ZIOCC/Zio-Qwiic-Micropython-Pyboard--STM32/images/2.jpg

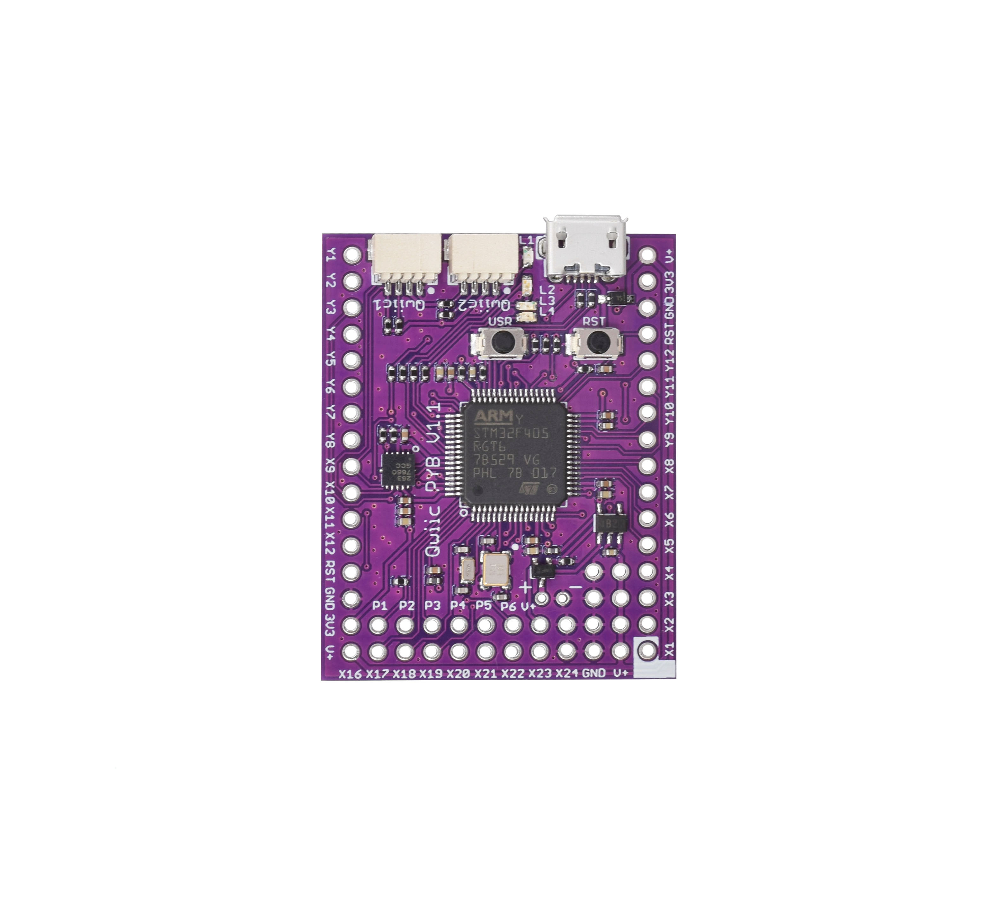
images/2.jpg
