ZIOCC/Zio-Qwiic-Micropython-Pyboard--STM32/images/4.jpg

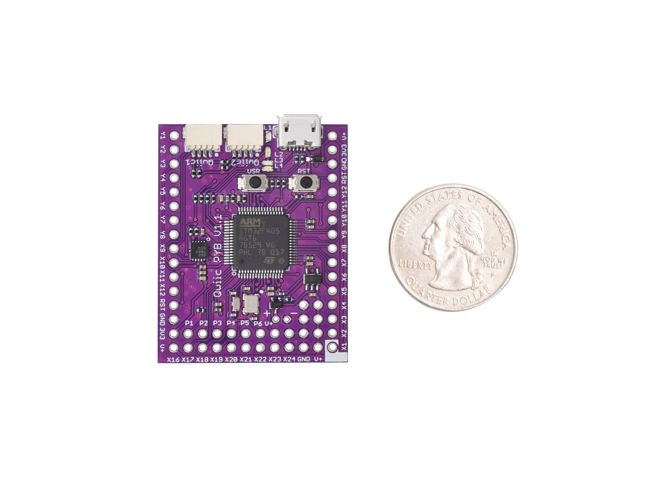
images/4.jpg
