ZIOCC/Zio-Qwiic-Micropython-Pyboard--STM32/images/1.jpg

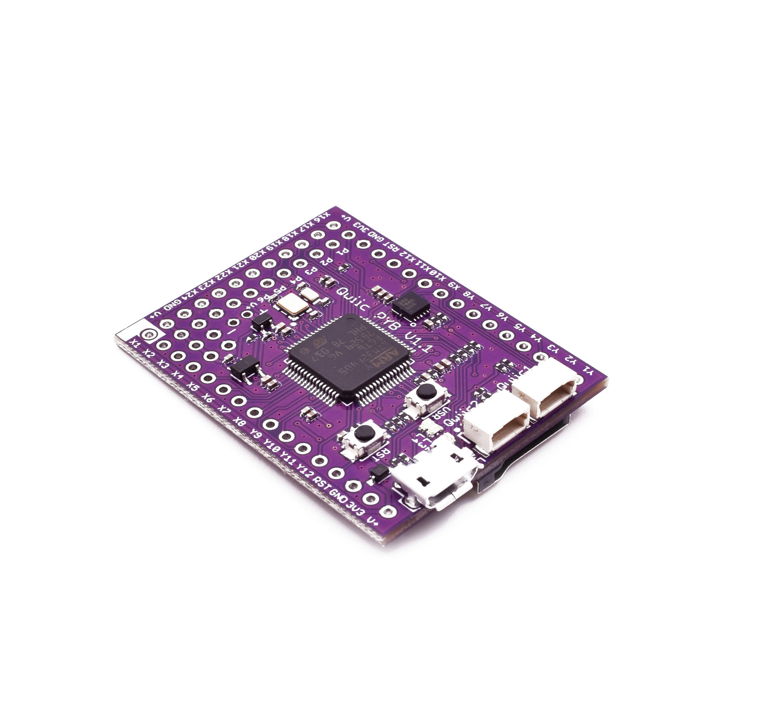
images/1.jpg
