ZIOCC/Zio-Qwiic-Micropython-Pyboard--STM32/images/3.jpg

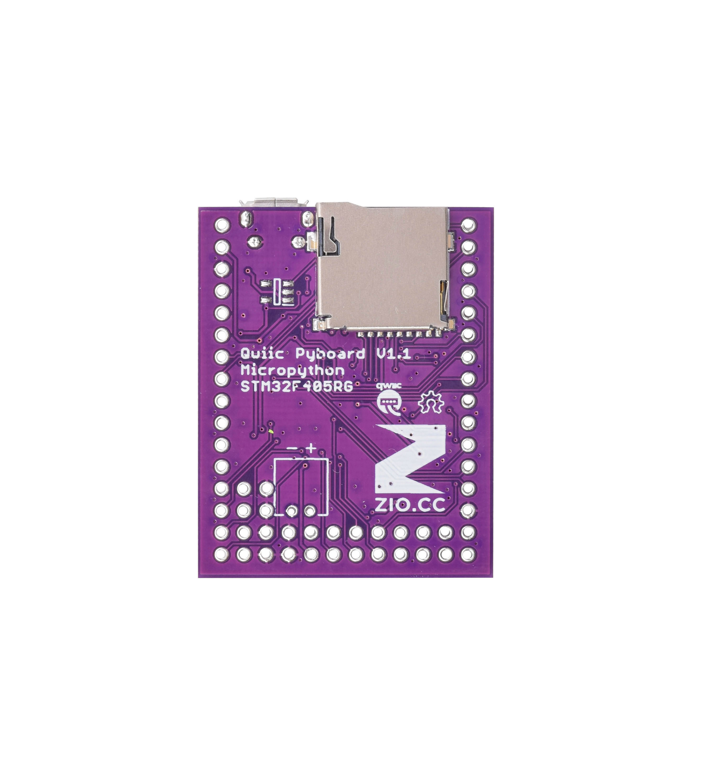
images/3.jpg
