ZIOCC/Zio-Qwiic-Micropython-Pyboard--STM32/BOM.xlsx

 | BOM/PCBA quantity:
 | Project Name:
# | Part ID/Reference | Manufacturer | Part Number | Description | Value | Package | THT | Pins/Pads Qty | Source/Link/Datasheet/Note | Quantity/per BOM | NOTE
1 | C1, C2, C11, C12 |  |  |  | 10pF ±5% 50V | C0402 |  |  |  | 4
2 | C3, C4, C5, C6, C8, C9, C13, C14, C15 |  |  |  | 100nF ±10% 50V | C0402 |  |  |  | 9
3 | C7, C10, C16, C18 |  |  |  | 4.7uF ±20% 6.3V | C0402 |  |  |  | 4
4 | C17, C19, C20 |  |  |  | 2.2uF ±10% 10V | C0402 |  |  |  | 3
5 | D1 |  | 1N5819WS |  | 1N5819WS | SOD323 |  |  |  | 1
6 | D2 |  |  |  | RED | LED-0603 |  |  |  | 1
7 | D3 |  |  |  | GREEN | LED-0603 |  |  |  | 1
8 | D4 |  |  |  | YELLOW | LED-0603 |  |  |  | 1
9 | D5 |  |  |  | BLUE | LED-0603 |  |  |  | 1
10 | IC1 |  | STM32F405RGT |  | STM32F405RGT | LQFP64 |  |  |  | 1
11 | J1 |  | 带自弹TF卡座 |  | TF_CARD | TF_CARD |  |  |  | 1
12 | J2 |  | U-F-M5DD-Y-L |  | U-F-M5DD-Y-L | MICRO-SMD |  |  |  | 1
13 | J3, J6, J7, J8, J9, J10 |  | NA |  | NA | 8P-2.54-60/35MIL-NS |  |  |  | 6
14 | J4, J5 |  |  |  | JST-SH-4P-1.0 | JST-SH-4P |  |  |  | 2
15 | J12 |  | NA |  | NA | 2X4P-2.54-NS |  |  |  | 1
16 | J13 |  | NA |  | NA | PH2.0-2P-90 |  |  |  | 1
17 | K1, K2 |  | SKRKAEE020 |  | SKRKAEE020 | SKRKAEE020 |  |  |  | 2
18 | L1 |  | BLM15AG102SN1D |  | BLM15AG102SN1D | L0402 |  |  |  | 1
19 | Q1 |  | DMP2160UW-7 |  | DMP2160UW-7 | SOT-323 |  |  |  | 1
20 | R1, R2 |  |  |  | 22R ±1% | R0402 |  |  |  | 2
21 | R3, R8, R9, R11, R12, R17 |  |  |  | 4.7K ±1% | R0402 |  |  |  | 6
22 | R4, R5, R6, R7, R10, R16 |  |  |  | 560R ±1% | R0402 |  |  |  | 6
23 | R13, R14, R15, R18, R20, R21 |  |  |  | 100K ±1% | R0402 |  |  |  | 6
24 | R19 |  | BLM15AX221SN1D |  | 220R ±1% | R0402 |  |  |  | 1
25 | S1 |  | NA |  | NA/MIC2005A-1YM5-TR | SOT95P280X130-5N |  |  |  | 1
26 | U1 |  | MMA7660FC |  | MMA7660FC | DFN10 |  |  |  | 1
27 | U2 |  | XC6210B332MR |  | XC6210B332MR | SOT23-5 |  |  |  | 1
28 | X1 |  | SX32Y012000BK1T |  | 12MHZ(SX32Y012000BK1T) | 4P-SMD-3.2X2.5 |  |  |  | 1
29 | X2 |  | X201232768KGD2SI |  | 32.768KHZ(X201232768KGD2SI) | 2.0X12MM |  |  |  | 1
