ZIOCC/Zio-Qwiic-Micropython-Pyboard--STM32/zio Qwiic micropython pyboard v1.1 sch.pdf

# +3V3 GND

# +3V3 100nF ±10% ⁵⁰V GND

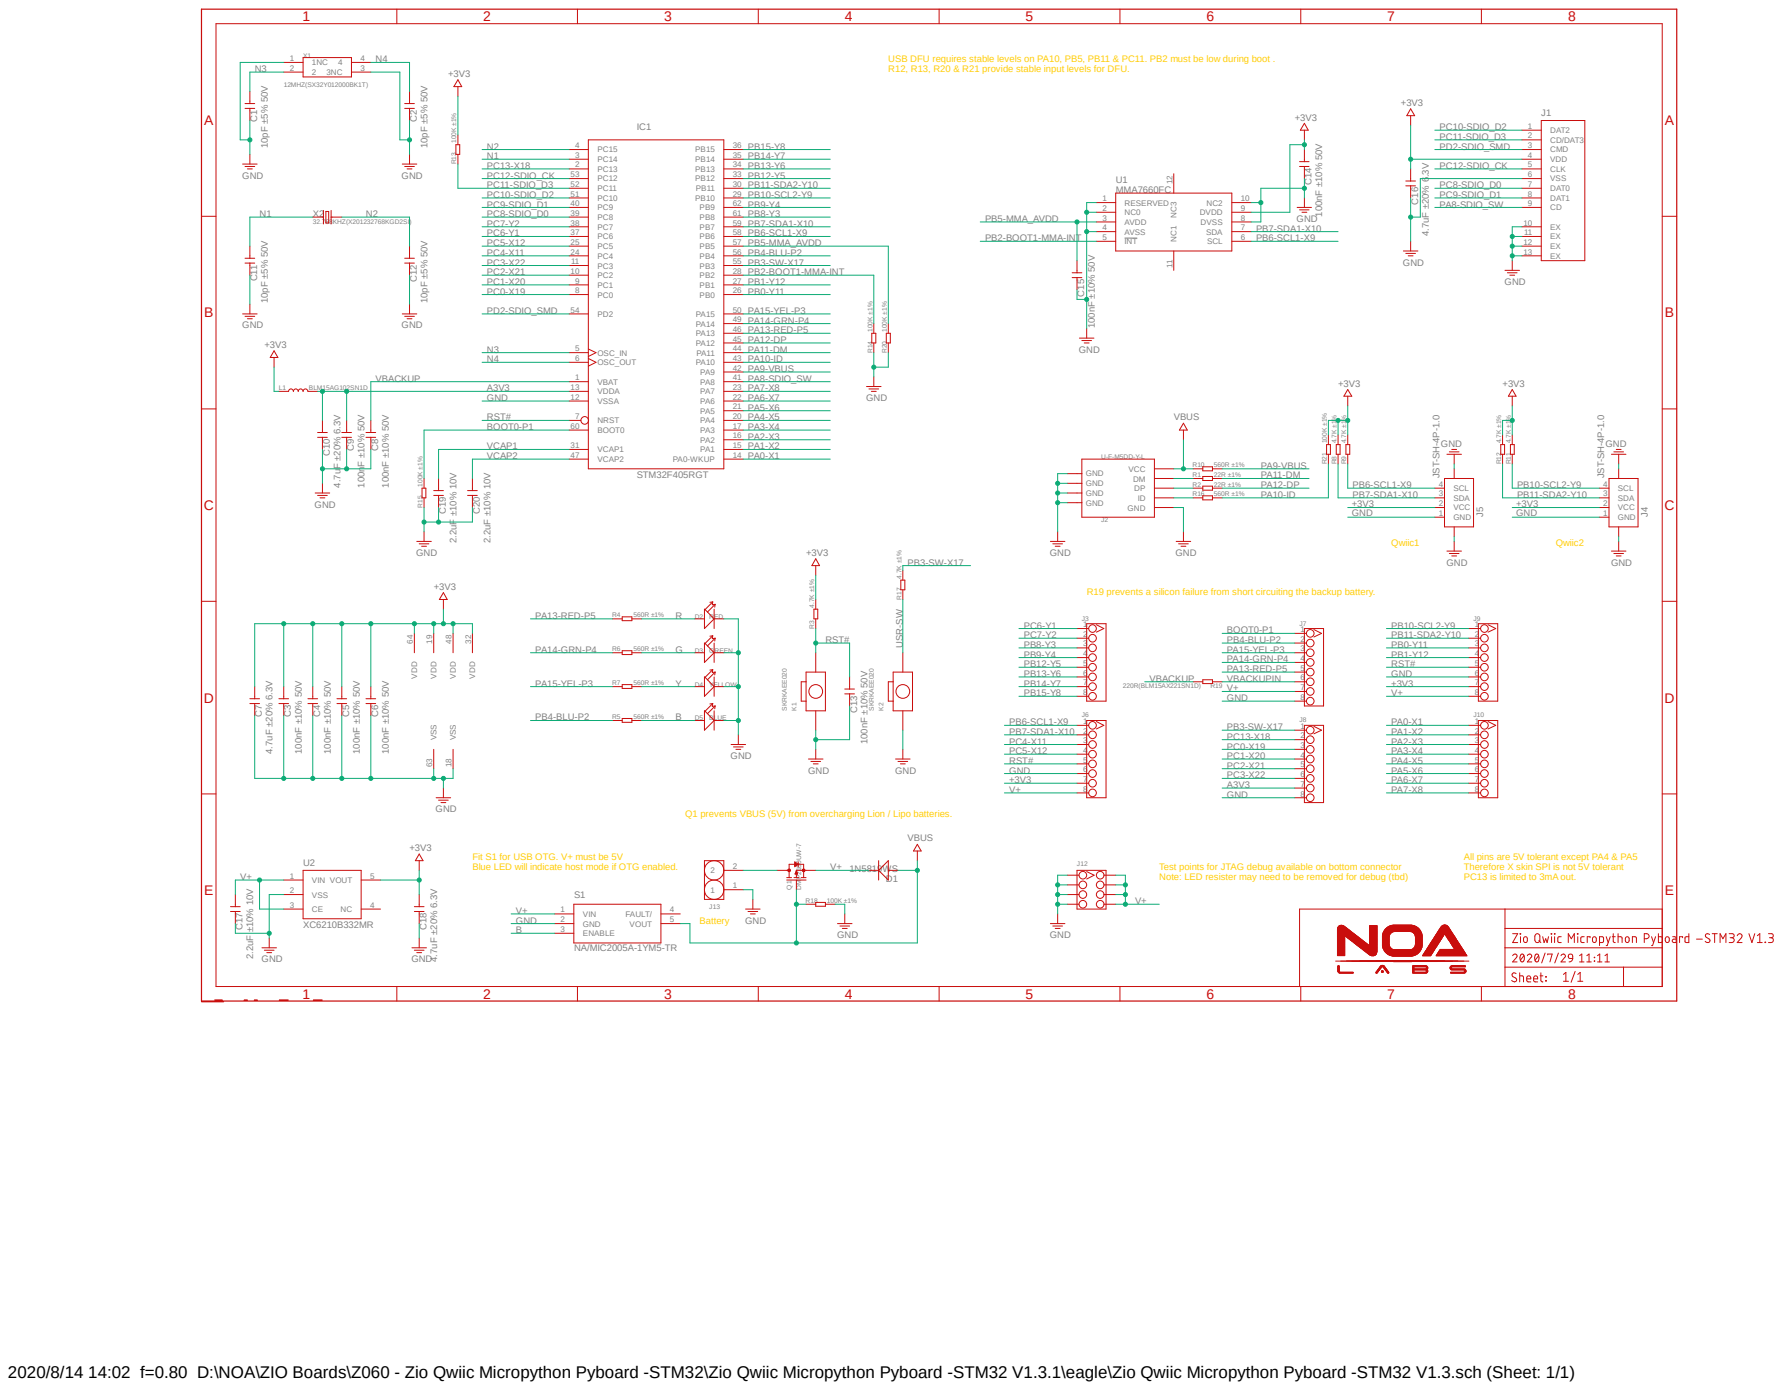
[picture p5: page 1]

USB DFU requires stable levels on PA10, PB5, PB11 & PC11. PB2 must be low during boot .
R12, R13, R20 & R21 provide stable input levels for DFU.

VCC GND GND GND GND

R19 prevents a silicon failure from short circuiting the backup battery.

All pins are 5V tolerant except PA4 & PA5 Therefore X skin SPI is not 5V tolerant PC13 is limited to 3mA out.

Note: LED resister may need to be removed for debug (tbd)

2020/8/14 14:02 f=0.80 D:\NOA\ZIO Boards\Z060 - Zio Qwiic Micropython Pyboard -STM32\Zio Qwiic Micropython Pyboard -STM32 V1.3.1\eagle\Zio Qwiic Micropython Pyboard -STM32 V1.3.sch (Sheet: 1/1)
