ZIOCC/Zio-Qwiic-Micropython-Pyboard--STM32/eagle/Zio Qwiic Micropython Pyboard -STM32 V1.3.brd

## EAGLE design eagle/Zio Qwiic Micropython Pyboard -STM32 V1.3.brd (2020-08-14)

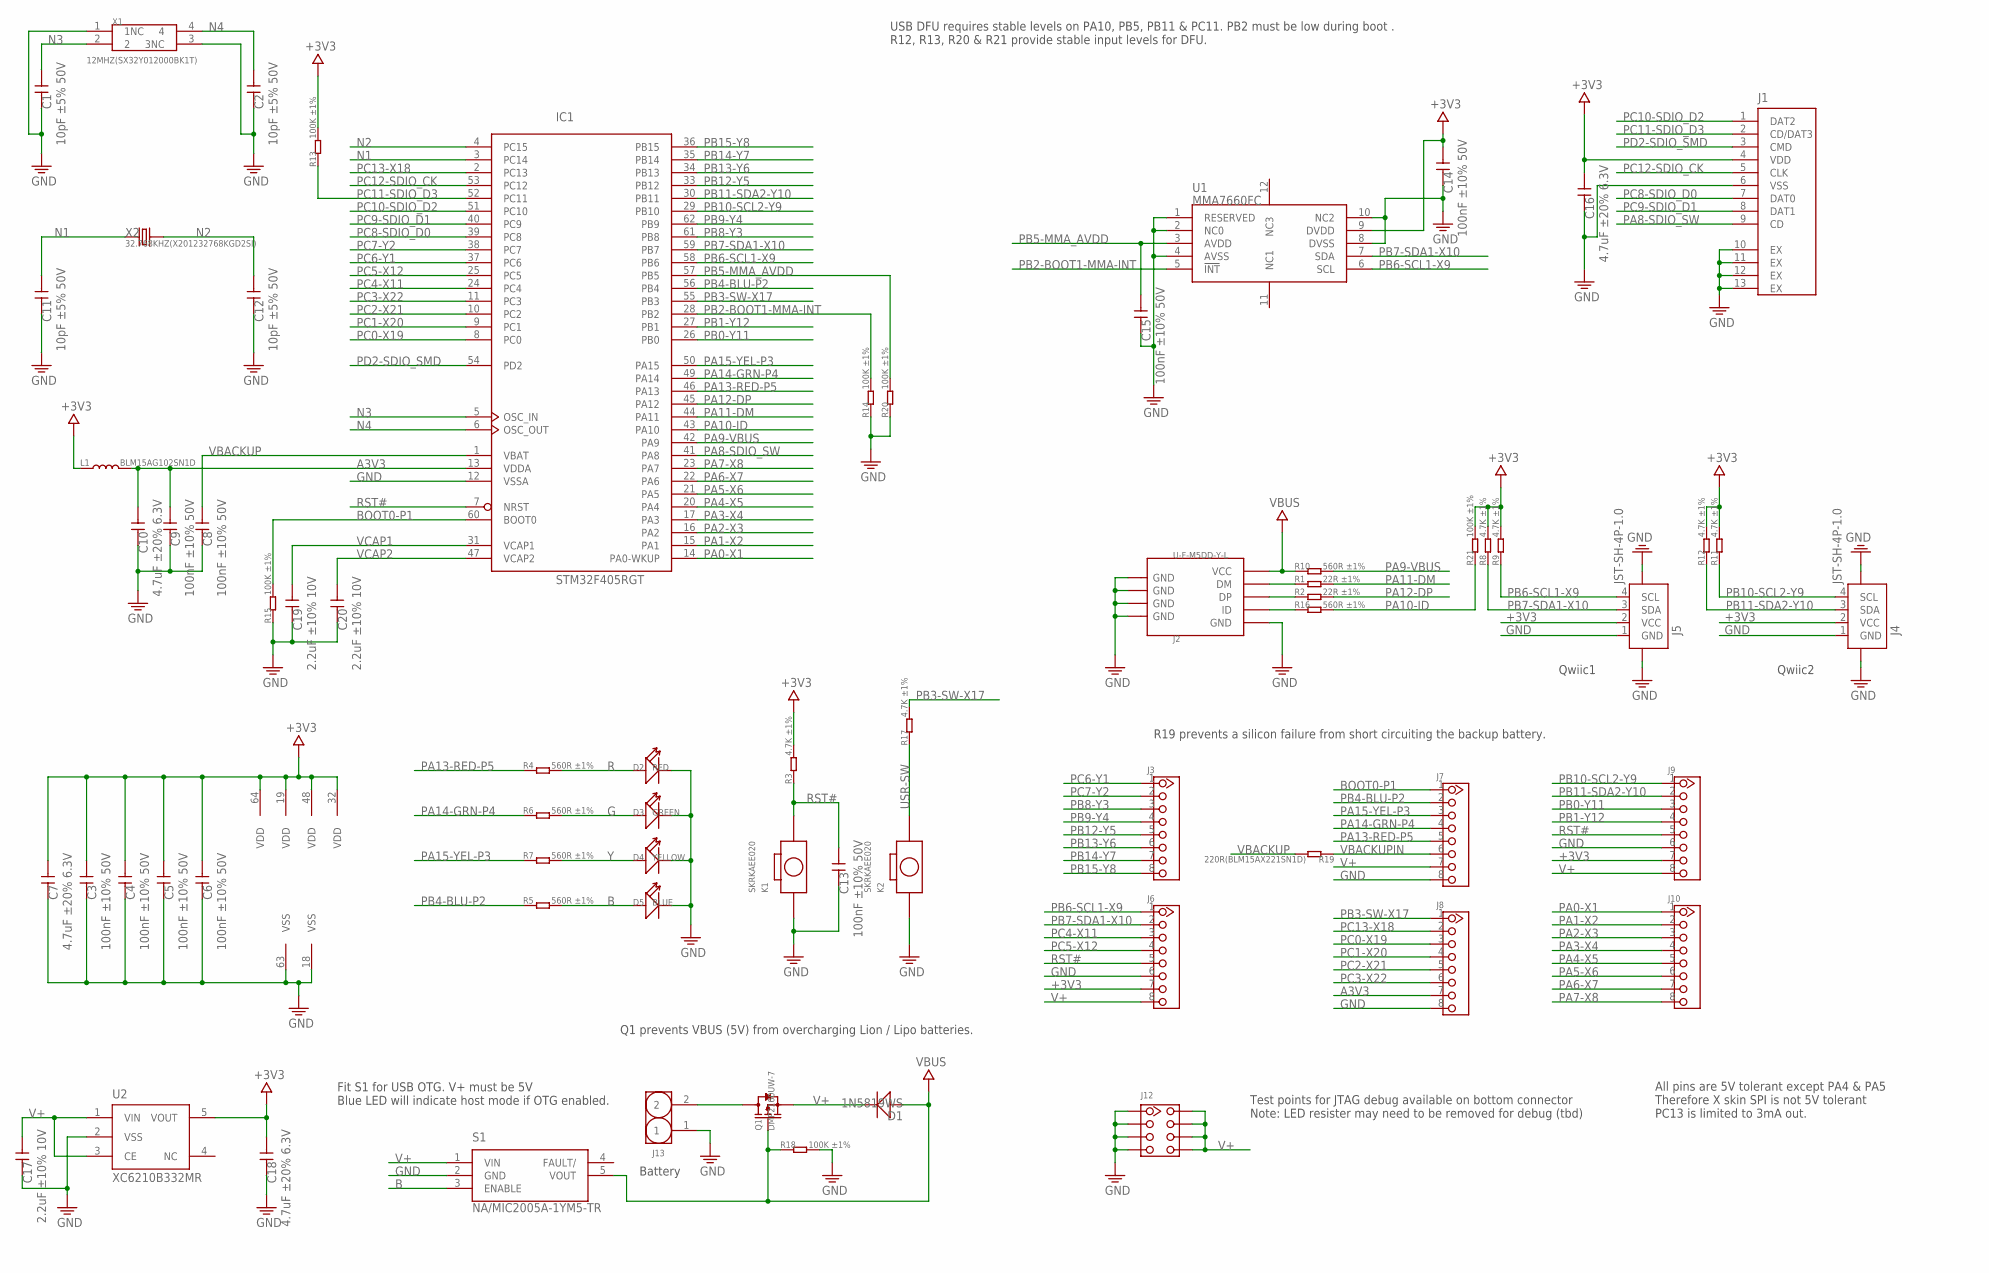
[picture p6: schematic Zio Qwiic Micropython Pyboard -STM32 V1.3.sch]

Parts:
C1, C2, C11, C12: 10pF ±5% 50V; C0402
C3, C4, C5, C6, C8, C9, C13, C14, C15: 100nF ±10% 50V; C0402
C7, C10, C16, C18: 4.7uF ±20% 6.3V; C0402
C17, C19, C20: 2.2uF ±10% 10V; C0402
D1: 1N5819WS; SOD323
D2: RED; LED-0603
D3: GREEN; LED-0603
D4: YELLOW; LED-0603
D5: BLUE; LED-0603
IC1: STM32F405RGT; LQFP64
J1: TF_CARD
J2: U-F-M5DD-Y-L; MICRO-SMD
J3, J6, J7, J8, J9, J10: HEADER-8P-NS; 8P-2.54-60/35MIL-NS
J4, J5: JST-SH-4P-1.0; JST-SH-4P
J12: HEADER-2X4P-NS; 2X4P-2.54-NS
J13: HEADER-2P-2.0-90; PH2.0-2P-90
K1, K2: SKRKAEE020
L1: BLM15AG102SN1D; L0402
Q1: DMP2160UW-7; SOT-323
R1, R2: 22R ±1%; R0402
R3, R8, R9, R11, R12, R17: 4.7K ±1%; R0402
R4, R5, R6, R7, R10, R16: 560R ±1%; R0402
R13, R14, R15, R18, R20, R21: 100K ±1%; R0402
R19: 220R(BLM15AX221SN1D); R0402
S1: NA/MIC2005A-1YM5-TR; SOT95P280X130-5N
U1: MMA7660FC; DFN10
U2: XC6210B332MR; SOT23-5
X1: 12MHZ(SX32Y012000BK1T); 4P-SMD-3.2X2.5
X2: 32.768KHZ(X201232768KGD2SI); 2.0X12MM

Connections:
+3V3: C3.2, C4.2, C5.2, C6.2, C7.2, C14.2, C16.2, C18.2, IC1.19 (VDD), IC1.32 (VDD), IC1.48 (VDD), IC1.64 (VDD), J1.4 (VDD), J4.2 (VCC), J5.2 (VCC), J6.7, J9.7, L1.1, R3.2, R8.2, R9.2, R11.2, R12.2, R13.2, R21.2, U1.9 (DVDD), U2.5 (VOUT)
A3V3: C9.2, C10.2, IC1.13 (VDDA), J8.7, L1.2
B: D5.+, R5.2, S1.3 (ENABLE)
BOOT0-P1: IC1.60 (BOOT0), J7.1, R15.2
G: D3.+, R6.2
GND: C1.1, C2.1, C3.1, C4.1, C5.1, C6.1, C7.1, C8.1, C9.1, C10.1, C11.1, C12.1, C13.1, C14.1, C15.1, C16.1, C17.1, C18.1, C19.1, C20.1, D2.-, D3.-, D4.-, D5.-, IC1.12 (VSSA), IC1.18 (VSS), IC1.63 (VSS), J1.6 (VSS), J1.10 (EX), J1.11 (EX), J1.12 (EX), J1.13 (EX), J2.GND, J2.S1 (GND), J2.S1@1 (GND), J2.S1@2 (GND), J2.S2 (GND), J2.S2@1 (GND), J2.S2@2 (GND), J2.S3 (GND), J2.S3@1 (GND), J2.S3@2 (GND), J2.S4 (GND), J2.S4@1 (GND), J2.S4@2 (GND), J2.S5 (GND), J2.S6 (GND), J4.1 (GND), J4.NC1 (5), J4.NC2 (6), J5.1 (GND), J5.NC1 (5), J5.NC2 (6), J6.6, J7.8, J8.8, J9.6, J12.1, J12.2, J12.3, J12.4, J13.1, K1.1, K2.1, R14.1, R15.1, R18.2, R20.1, S1.2 (GND), U1.1 (RESERVED), U1.2 (NC0), U1.4 (AVSS), U1.8 (DVSS), U1.10 (NC2), U2.2 (VSS), X1.1 (1NC), X1.3 (3NC)
N1: C11.2, IC1.3 (PC14), X2.1
N2: C12.2, IC1.4 (PC15), X2.2
N3: C1.2, IC1.5 (OSC_IN), X1.2
N4: C2.2, IC1.6 (OSC_OUT), X1.4
unnamed: J2.D- (DM), R1.1
unnamed: J2.D+ (DP), R2.1
unnamed: J2.ID, R16.1
unnamed: J13.2, Q1.3 (D)
PA0-X1: IC1.14 (PA0-WKUP), J10.1
PA1-X2: IC1.15 (PA1), J10.2
PA2-X3: IC1.16 (PA2), J10.3
PA3-X4: IC1.17 (PA3), J10.4
PA4-X5: IC1.20 (PA4), J10.5
PA5-X6: IC1.21 (PA5), J10.6
PA6-X7: IC1.22 (PA6), J10.7
PA7-X8: IC1.23 (PA7), J10.8
PA8-SDIO_SW: IC1.41 (PA8), J1.9 (CD)
PA9-VBUS: IC1.42 (PA9), R10.2
PA10-ID: IC1.43 (PA10), R16.2, R21.1
PA11-DM: IC1.44 (PA11), R1.2
PA12-DP: IC1.45 (PA12), R2.2
PA13-RED-P5: IC1.46 (PA13), J7.5, R4.1
PA14-GRN-P4: IC1.49 (PA14), J7.4, R6.1
PA15-YEL-P3: IC1.50 (PA15), J7.3, R7.1
PB0-Y11: IC1.26 (PB0), J9.3
PB1-Y12: IC1.27 (PB1), J9.4
PB2-BOOT1-MMA-INT: IC1.28 (PB2), R14.2, U1.5 (!INT)
PB3-SW-X17: IC1.55 (PB3), J8.1, R17.2
PB4-BLU-P2: IC1.56 (PB4), J7.2, R5.1
PB5-MMA_AVDD: C15.2, IC1.57 (PB5), R20.2, U1.3 (AVDD)
PB6-SCL1-X9: IC1.58 (PB6), J5.4 (SCL), J6.1, R9.1, U1.6 (SCL)
PB7-SDA1-X10: IC1.59 (PB7), J5.3 (SDA), J6.2, R8.1, U1.7 (SDA)
PB8-Y3: IC1.61 (PB8), J3.3
PB9-Y4: IC1.62 (PB9), J3.4
PB10-SCL2-Y9: IC1.29 (PB10), J4.4 (SCL), J9.1, R11.1
PB11-SDA2-Y10: IC1.30 (PB11), J4.3 (SDA), J9.2, R12.1
PB12-Y5: IC1.33 (PB12), J3.5
PB13-Y6: IC1.34 (PB13), J3.6
PB14-Y7: IC1.35 (PB14), J3.7
PB15-Y8: IC1.36 (PB15), J3.8
PC0-X19: IC1.8 (PC0), J8.3
PC1-X20: IC1.9 (PC1), J8.4
PC2-X21: IC1.10 (PC2), J8.5
PC3-X22: IC1.11 (PC3), J8.6
PC4-X11: IC1.24 (PC4), J6.3
PC5-X12: IC1.25 (PC5), J6.4
PC6-Y1: IC1.37 (PC6), J3.1
PC7-Y2: IC1.38 (PC7), J3.2
PC8-SDIO_D0: IC1.39 (PC8), J1.7 (DAT0)
PC9-SDIO_D1: IC1.40 (PC9), J1.8 (DAT1)
PC10-SDIO_D2: IC1.51 (PC10), J1.1 (DAT2)
PC11-SDIO_D3: IC1.52 (PC11), J1.2 (CD/DAT3), R13.1
PC12-SDIO_CK: IC1.53 (PC12), J1.5 (CLK)
PC13-X18: IC1.2 (PC13), J8.2
PD2-SDIO_SMD: IC1.54 (PD2), J1.3 (CMD)
R: D2.+, R4.2
RST#: C13.2, IC1.7 (NRST), J6.5, J9.5, K1.2, R3.1
USR-SW: K2.2, R17.1
V+: C17.2, D1.-, J6.8, J7.7, J9.8, J12.5, J12.6, J12.7, J12.8, Q1.2 (S), S1.1 (VIN), U2.1 (VIN), U2.3 (CE)
VBACKUP: C8.2, IC1.1 (VBAT), R19.2
VBACKUPIN: J7.6, R19.1
VBUS: D1.+, J2.VBUS (VCC), Q1.1 (G), R10.1, R18.1, S1.5 (VOUT)
VCAP1: C19.2, IC1.31 (VCAP1)
VCAP2: C20.2, IC1.47 (VCAP2)
Y: D4.+, R7.2

Notes on the sheet:
Qwiic1
Qwiic2
Battery
USB DFU requires stable levels on PA10, PB5, PB11 & PC11. PB2 must be low during boot . R12, R13, R20 & R21 provide stable input levels for DFU.
Q1 prevents VBUS (5V) from overcharging Lion / Lipo batteries.
Fit S1 for USB OTG. V+ must be 5V Blue LED will indicate host mode if OTG enabled.
Test points for JTAG debug available on bottom connector Note: LED resister may need to be removed for debug (tbd)
R19 prevents a silicon failure from short circuiting the backup battery.
All pins are 5V tolerant except PA4 & PA5 Therefore X skin SPI is not 5V tolerant PC13 is limited to 3mA out.

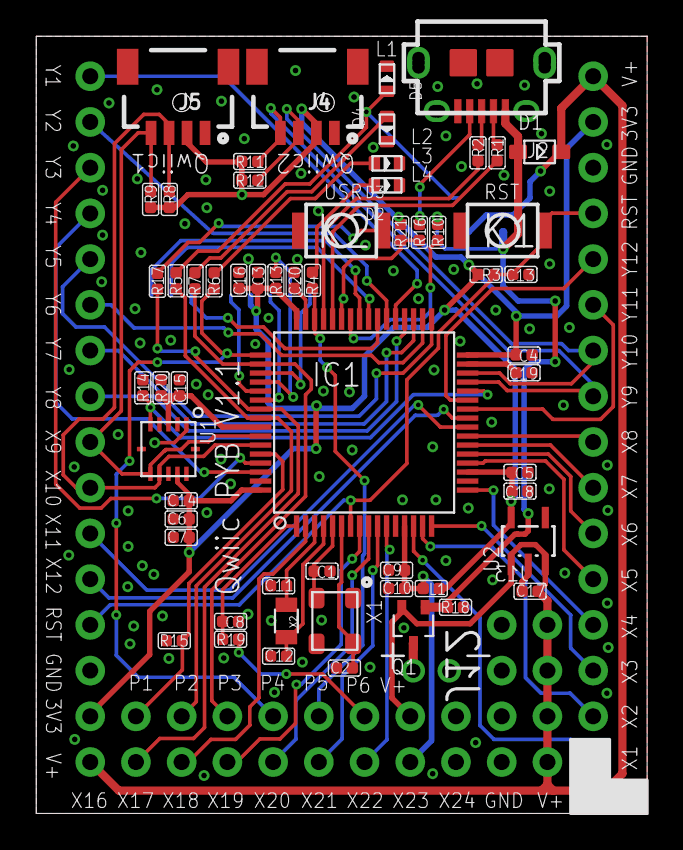
[picture p7: board Zio Qwiic Micropython Pyboard -STM32 V1.3.brd from above]

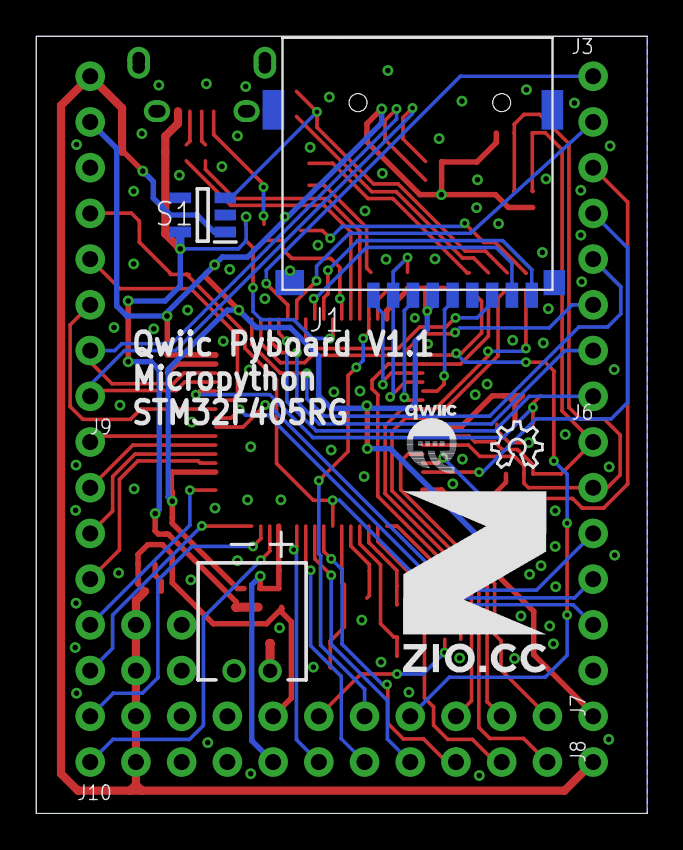
[picture p8: board Zio Qwiic Micropython Pyboard -STM32 V1.3.brd from below]

Board: 2 copper layers, 33.9 x 43.2 mm, 71 parts (13 on the bottom side), 71 nets.

Other parts of the board:
U$12: 10MM
U$13: QWIIC-LOGO-SMALL
U$14: OSHW_6X100_NOTEXT
